xcwxcwxcw321-sketch/2026-stm32-/README.md

# STM32 + Raspberry Pi 钢球水管平衡系统

本仓库整理竞赛装置的两部分：STM32 负责循迹小车/直流电机的底层闭环，树莓派负责摄像头视觉、D36A 步进轴和钢球平衡网页。两部分可以独立调试，也可以通过串口参数接口联调。

## 1. 系统组成与信号流

~~~text
摄像头 ──> 树莓派视觉识别 ──> 钢球位置/速度估计 ──> 单环 PD、静差补偿、脱困逻辑
                                                    │
                                                    └─> GPIO STEP/DIR/EN ──> D36A ──> 步进电机/摆杆

编码器 ──> STM32 ──> 直流电机速度/方向控制 ──> 小车
树莓派 UART4 <──> STM32 USART1：读取和修改车辆闭环参数
~~~

树莓派侧的文件名中仍保留 cascade 等历史名称，但当前网页使用的是“单环 PD + 低速静差补偿”控制：位置误差换算为步进位置，微分项抑制小球速度，静差补偿和防卡滞逻辑只在满足条件时生效。STM32 侧是车辆直流电机的编码器反馈闭环，不是 D36A 步进轴的位置环。

## 2. STM32 部分：小车与直流电机闭环

### 功能如何实现

1. User/main.c 初始化时钟、GPIO、定时器、PWM、编码器、USART1 和 OLED，然后在周期任务中读取左右轮编码器。
2. 编码器增量换算为轮速，速度误差进入电机 PID/PWM 调节；方向、停止计数和基础速度由 Hardware/Motor.*、Hardware/PWM.*、Hardware/Encoder.* 协同完成。
3. Hardware/UART.* 按行接收树莓派命令，Hardware/RemoteParams.* 解析参数并返回状态；Hardware/ParamStorage.* 负责 SAVE/LOAD/DEFAULT 的 Flash 参数保存与恢复。
4. OLED 用于本地观察运行状态和关键参数，便于脱离网页进行底层排查。

工程入口为 stm32/1-1.uvprojx，主要源码目录如下：

- stm32/User/：主循环、中断和系统入口。
- stm32/Hardware/：电机、PWM、编码器、UART、远程参数、Flash 参数和 OLED。
- stm32/Library/、stm32/Start/、stm32/System/：STM32F1 外设库、启动文件和延时/系统支持。

### 串口协议

树莓派 UART4 与 STM32 USART1 使用 115200 8N1，支持：

~~~text
GET                 读取当前参数
STATUS              读取运行状态
SET,TKP,0.60        设置一个参数（网页也可直接加减）
SAVE                保存到 STM32 Flash
LOAD                从 Flash 载入
DEFAULT             恢复默认值
HELP                返回命令和参数名
~~~

可调参数：VKP、VKI、TKP、TKD、P1_MAX、P2_MAX、AB_MAX、P1_STOP、P2_STOP、AB_STOP、CENTER、DEAD、MAX_TURN。各 MAX 参数是输出限幅，各 STOP 参数是停止/死区相关阈值，CENTER、DEAD、MAX_TURN 用于循迹中心和转向范围。

### 树莓派到 STM32 接线

| 树莓派物理引脚 | BCM GPIO | 作用 | STM32 |
|---:|---:|---|---|
| 24 | GPIO8 | UART4 TX | PA10 / USART1_RX |
| 21 | GPIO9 | UART4 RX | PA9 / USART1_TX |
| 20 或 25 | GND | 共地 | GND |

只允许在确认两端都是 3.3 V TTL 电平时直连；STM32 侧若使用 5 V 电平，必须加电平转换，不能把 5 V 或 12 V 信号接入树莓派 GPIO。

## 3. 树莓派部分：视觉与 D36A 平衡

### 3.1 视觉识别

raspberry-pi/detect_ball_stabilized.py 提供摄像头服务和网页视频流。当前识别流程为：

1. 从 640×480、约 30 FPS 的摄像头帧中裁剪管子/紫色框区域，降低背景干扰。
2. 进行亮度归一化和灰度/阈值处理，减少不同光照下的过曝、阴影影响。
3. 同时使用轮廓候选和一维灰度投影；钢球轮廓破碎、贴近边缘或车辆振动时，投影仍可提供位置候选。
4. 用置信度、短时跟踪和 Kalman/预测结果过滤单帧误判；连续丢帧时短暂保持预测，不立即把钢球位置跳到画面边缘。
5. 通过 /status.json 输出球坐标、检测源（fused/contour/projection）、置信度和帧率，通过 /stream.mjpg 输出调试画面。

主要文件：

- detect_ball_stabilized.py：视觉服务和识别算法。
- stabilized_vision_settings.json：裁剪范围、阈值、曝光和跟踪参数。
- d36a_cascade_direct_web.py：D36A 控制网页、步进轴、按钮、串口参数面板和控制状态机。

### 3.2 D36A 步进轴控制

网页从视觉服务读取球的横向坐标，按管长标定把像素换算为厘米，再将位置误差换算为步数。控制器包含：

- PD 位置控制：比例项产生调节步数，微分项按球的运动速度提前刹车。
- 左右独立力度系数：补偿水管左右摩擦不一致。
- 有限幅的低速静差补偿：球在目标附近且速度足够低时才补偿，避免积分累积后突然高速冲出。
- 防卡滞/脱困：球长时间有误差但几乎不动时，沿目标方向施加一次较大的推力；检测到位移或速度后退出脱困并回到闭环。
- 软限位和标定：默认步数范围为 0..681，中心参考约为 235；最低点可以通过网页或 GPIO 按钮重新设为 0。
- 开环运动题：可先向 +5 cm 方向推杆，再切换闭环折返到 -5 cm；常规平衡也可直接设定 -12.5..+12.5 cm 目标。

### 3.3 D36A GPIO 和硬件按键

| BCM GPIO | 物理脚 | 作用 |
|---:|---:|---|
| 22 | 15 | EN1 |
| 23 | 16 | DIR1 |
| 18 | 12 | STEP1 |
| 5 | 29 | 紧急停止，低电平有效 |
| 6 | 31 | 确认最低点/参考零点，低电平有效 |
| 16 | 36 | 开启零点闭环，低电平有效 |
| 20 | 38 | 运行开环到 +5 再闭环到 -5，低电平有效 |
| 26 | 37 | 发车/停车信号：上升沿向右前馈，下降沿向左停车前馈 |

按钮一端接对应 GPIO，另一端接树莓派任意 GND，程序使用内部上拉，因此按下时为低电平。GPIO26 的外部信号源也必须与树莓派共地并满足 3.3 V 电平要求。

### 3.4 标定和操作顺序

1. 确认 D36A 使用独立 12 V 电源，树莓派使用稳定的 5 V 电源；两者只通过信号地共地。
2. 机械上把摆杆移动到最低点，点击网页“确认最低点”或按 GPIO6，再开启零点闭环。
3. 检查 0..681 软限位和方向：手动单步时，步数增加应朝预期方向移动；方向反了先改 DIR 逻辑，不要用大步数硬顶。
4. 放入钢球，先用较小 PD 和较小最大步数观察，再逐步增加响应；如果球卡住，使用脱困参数而不是无限增大积分。
5. 紧急情况按 GPIO5 或网页急停。急停后重新确认最低点，避免软件步数与实际机械位置失配。

## 4. 物料清单

### 必需物料

- Raspberry Pi（带可用 GPIO、稳定 5 V 供电）和 microSD 卡。
- USB 摄像头（V4L2 可识别），摄像头支架和可调光源。
- D36A 步进电机驱动器、匹配的步进电机、独立 12 V 大容量电池/电源、保险或急停保护。
- 钢球、水管/摆杆、步进电机联轴结构、可靠机械限位或可重复的最低点定位结构。
- STM32F103 开发板、直流电机驱动、电机、左右轮编码器和小车电源。
- 3.3 V TTL 串口线、杜邦线/端子、共地线、按钮（至少急停、最低点、零点闭环、运行四个）。

### 推荐物料

- UART 电平转换器（当 STM32 串口不是 3.3 V TTL 时必须使用）。
- 独立 5 V 降压模块给树莓派供电，避免从 D36A 的 VOUT 或 GPIO 给树莓派供电。
- 机械急停、行程保护、保险丝、屏蔽/固定良好的摄像头线和步进电机线。

## 5. 部署和访问

树莓派上的两个服务文件位于 deployment/autostart/：

- hball-gray.service：启动视觉服务，默认监听 8080。
- d36a-stepper-control.service：启动 D36A 控制网页，默认监听 8081。

树莓派安装依赖后，将 raspberry-pi/ 文件复制到服务文件中的工作目录，并执行：

~~~bash
sudo systemctl enable --now hball-gray.service
sudo systemctl enable --now d36a-stepper-control.service
~~~

电脑浏览器访问 http://树莓派IP:8081/ 查看控制网页，访问 http://树莓派IP:8080/stream.mjpg 查看视频流。摄像头设备路径、IP 地址、工作目录和用户需要按实际机器修改；本仓库不保存树莓派密码，部署脚本通过环境变量 D36A_PI_PASSWORD 读取密码。

## 6. 安全与调试注意事项

- D36A 的 12 V 电源、步进电机电流和驱动器限流必须按驱动器手册和电机铭牌设置；不能因为驱动器标称电流就直接把 3 A 送入树莓派。
- 不要用树莓派 GPIO 给树莓派本身供电，也不要把 D36A 的未知 VOUT 直接接到树莓派 5 V/3.3 V 引脚。
- 上电前先断开电机或把轴置于中间，确认 EN、DIR、STEP 空闲电平和急停逻辑；首次测试使用单步和较低频率。
- 编码器可以用于观测电机，但当前 Pi 侧的轴位置保护主要依靠最低点参考和软件步数限位，不能把编码器当作已经安装好的硬限位。
- 任何改动后先用网页急停、再断电检查机械干涉；软件限位不是替代机械限位。
