xcwxcwxcw321-sketch/2026-stm32-/raspberry-pi/D36A_树莓派快速使用说明.md

# 树莓派控制 D36A 快速说明

## 先确认设备类型

D36A 是双路步进电机驱动板，不是普通三线舵机驱动板。它没有位置反馈，控制方式是：

- `EN`：低电平休眠，高电平使能。
- `DIR`：方向。
- `ST/STEP`：每个上升沿走一个细分步。
- PWM 频率决定转速，脉冲总数决定角度。

如果电机丢步，软件记录的位置也会错。需要绝对位置时，应增加原点开关或编码器。

## 推荐接线（BCM 编号）

| D36A | 树莓派 GPIO | 物理针脚 |
|---|---:|---:|
| EN1 | GPIO22 | 15 |
| DIR1 | GPIO23 | 16 |
| ST1 | GPIO18 | 12 |
| EN2 | GPIO24 | 18 |
| DIR2 | GPIO25 | 22 |
| ST2 | GPIO19 | 35 |
| GND | GND | 6 |

D36A 的 2×5 控制口按原理图为：

| 针脚 | 信号 | 针脚 | 信号 |
|---:|---|---:|---|
| 1 | ADC | 2 | 5V |
| 3 | EN2 | 4 | EN1 |
| 5 | DIR2 | 6 | DIR1 |
| 7 | STEP2 | 8 | STEP1 |
| 9 | GND | 10 | GND |

注意：

- 树莓派和 D36A 必须共地。
- 树莓派用自己的 USB-C 电源，D36A 的 `Vin+/Vin-` 用独立 12V 电源。
- 不要把 D36A 的 5V 接到树莓派 GPIO。
- D36A 的 5V 虽可给官方 STM32/Arduino 核心板供电，但不建议用它给树莓派反向供电。
- D36A 的逻辑高电平门限是 2.8V，树莓派 3.3V GPIO 可以直接控制。
- 接线和切换拨码前先断开 D36A 电源。

## 步进电机接线

两相四线步进电机接到 `A+、A-、B+、B-`。同一线圈的两根线是一组；不知道线序时，断电后用万用表电阻档找出两个导通线对。一组接 A 相，另一组接 B 相。方向不对时，在软件中使用负角度即可，不必带电换线。

## 拨码设置

拨到 `ON` 记为 1，断开记为 0。1~3 号设置两路共同的细分：

| 1 | 2 | 3 | 细分 |
|---:|---:|---:|---:|
| 1 | 1 | 1 | 1 |
| 0 | 1 | 1 | 2 |
| 0 | 1 | 0 | 4 |
| 1 | 0 | 0 | 8 |
| 0 | 0 | 0 | 16 |
| 1 | 0 | 1 | 32 |

4~6 号设置两路共同的相电流。首次测试建议全部拨到 `ON`，即 0.55A，再根据力矩逐步增加：

| 4 | 5 | 6 | 等效电流 |
|---:|---:|---:|---:|
| 1 | 1 | 1 | 0.55A |
| 1 | 1 | 0 | 0.59A |
| 1 | 0 | 1 | 0.70A |
| 1 | 0 | 0 | 0.77A |
| 0 | 1 | 1 | 0.83A |
| 0 | 1 | 0 | 0.93A |
| 0 | 0 | 1 | 1.22A |
| 0 | 0 | 0 | 1.44A |

不要把电流档调得高于电机允许范围；电流越大，驱动和电机发热越明显。

## 安装与运行

把 `d36a_pi_control.py` 复制到树莓派，然后安装 `lgpio`：

```bash
sudo apt update
sudo apt install -y python3-lgpio
python3 d36a_pi_control.py
```

直接命令示例：

```bash
# 电机1，正转90°，60 RPM，16细分
python3 d36a_pi_control.py move 1 90 --rpm 60 --microstep 16

# 电机1，反转一圈，30 RPM，8细分
python3 d36a_pi_control.py move 1 -360 --rpm 30 --microstep 8

# 电机2，反向200个脉冲，800 Hz
python3 d36a_pi_control.py steps 2 -200 --hz 800

# 电机1，以反向60 RPM运行2秒
python3 d36a_pi_control.py spin 1 2 --rpm -60 --microstep 16

# 不接硬件，只检查计算结果
python3 d36a_pi_control.py --dry-run move 1 90 --rpm 60 --microstep 16
```

对于 1.8° 电机：

```text
每圈脉冲数 = 200 × 细分
脉冲频率 Hz = RPM × 每圈脉冲数 ÷ 60
角度 = 脉冲数 ÷ 每圈脉冲数 × 360°
```

例如 16 细分时每圈 3200 个脉冲，60 RPM 对应 3200 Hz。

## 首次上电顺序

1. 先断电完成所有接线。
2. 拨码 1~3 设 16 细分：`OFF、OFF、OFF`。
3. 拨码 4~6 设最低 0.55A：`ON、ON、ON`。
4. 树莓派单独上电并启动脚本。
5. D36A 接 12V 并打开板上开关。
6. 先运行 `steps 1 200 --hz 200` 做低速短距离测试。
7. 如果只抖不转，先检查 A/B 两组线圈、共地、12V 电源电流能力，再降低频率。

资料依据：

- `D36A驱动用户手册_V1.5_2026.6.17.pdf`：第 11~13、16~22 页。
- `D36A双路步进电机驱动模块_V1.1(2026.04.20).pdf`：控制口与电路连接。
- `ATD5984.PDF`：第 4~8 页，逻辑门限和 STEP 时序。
