xcwxcwxcw321-sketch/2026-stm32-/docs/reference-github-repository.png

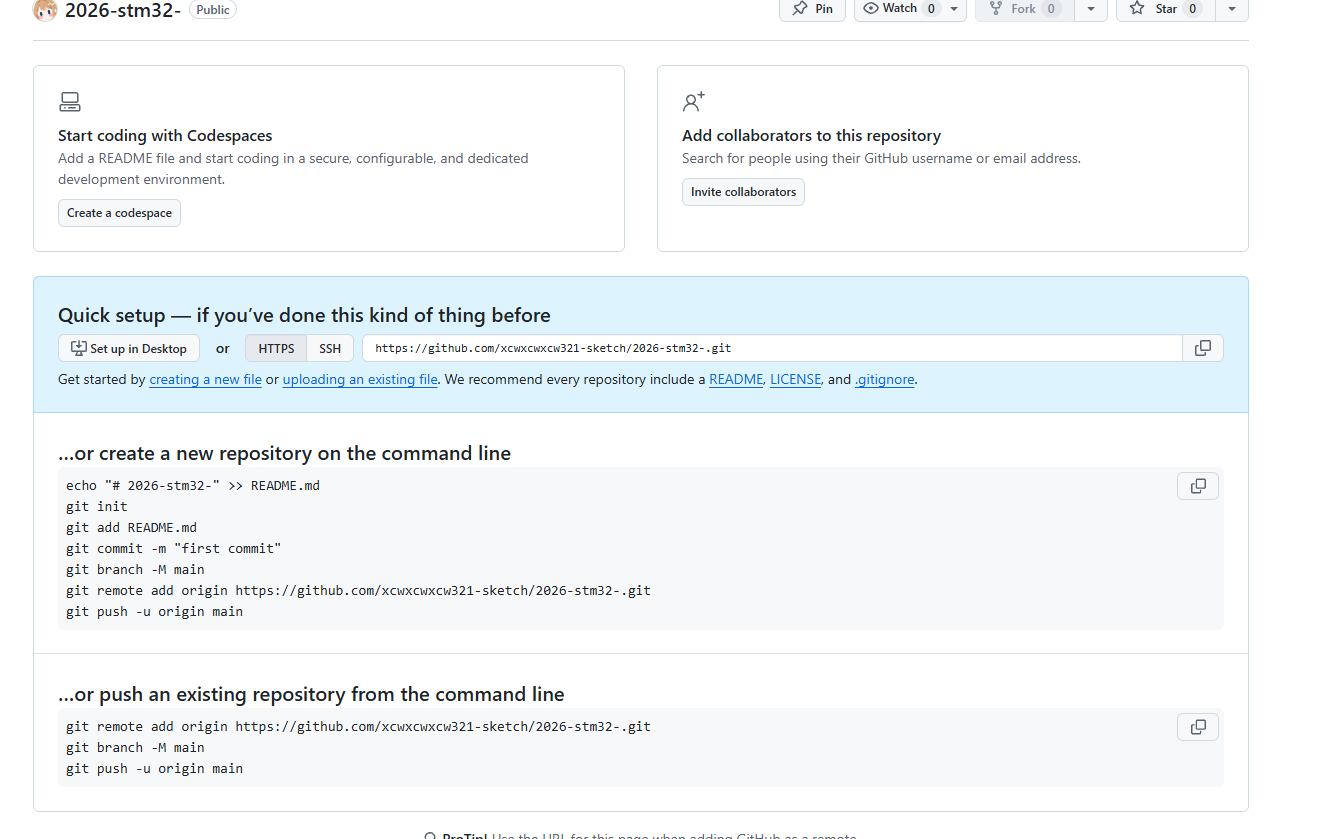
docs/reference-github-repository.png
