xcwxcwxcw321-sketch/2026-stm32-/stm32/Hardware/LightSensor.c

#include "stm32f10x.h"                  // Device header

void LightSensor_Init(void)
{
	
	RCC_APB2PeriphClockCmd(RCC_APB2Periph_GPIOB, ENABLE);
	GPIO_InitTypeDef GPIO_InitStructure;
	GPIO_InitStructure.GPIO_Mode= GPIO_Mode_IPU;
	GPIO_InitStructure.GPIO_Pin= GPIO_Pin_13;
	GPIO_InitStructure.GPIO_Speed= GPIO_Speed_50MHz;
	GPIO_Init(GPIOB, &GPIO_InitStructure);
}

uint8_t LightSensor_Get(void)
{
	return GPIO_ReadInputDataBit(GPIOB, GPIO_Pin_13);
}
