xcwxcwxcw321-sketch/2026-stm32-/(commit log)

2026-10-09 Initial STM32 and Raspberry Pi competition sources
2026-10-10 docs: explain STM32 and Raspberry Pi implementation
